jacintav/fotometro-portatil-icbm/electrónica/outputs/imagen 3D - pcb.png

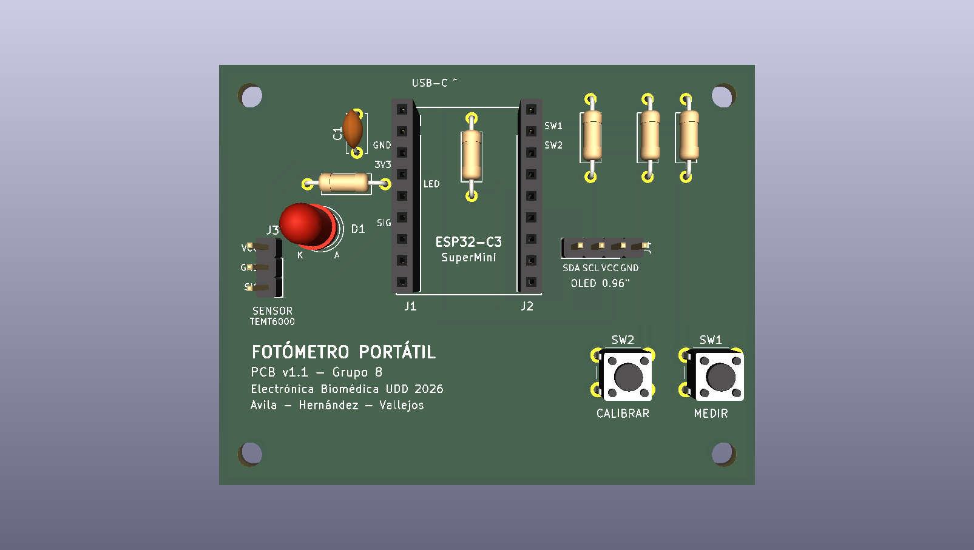
electrónica/outputs/imagen 3D - pcb.png
