jacintav/fotometro-portatil-icbm/software/README.md

# Software

Carpeta reservada para herramientas complementarias del proyecto. Por ahora no se utiliza, ya que el equipo funciona de forma autónoma con la pantalla OLED.
