jacintav/fotometro-portatil-icbm/electrónica/outputs/BOM.csv

Reference | Qty | Value | DNP | Exclude from BOM | Exclude from Board | Exclude from Simulation | Exclude from Position Files | Footprint | Datasheet
C1 | 1 | 100nF |  |  |  |  | ${EXCLUDE_FROM_POS_FILES} | Capacitor_THT:C_Disc_D5.0mm_W2.5mm_P5.00mm
D1 | 1 | LED |  |  |  |  | ${EXCLUDE_FROM_POS_FILES} | LED_THT:LED_D5.0mm
J1,J2 | 2 | Conn_01x09_Pin |  |  |  |  | ${EXCLUDE_FROM_POS_FILES} | Connector_PinSocket_2.54mm:PinSocket_1x09_P2.54mm_Vertical
J3 | 1 | Conn_01x03_Pin |  |  |  |  | ${EXCLUDE_FROM_POS_FILES} | Connector_PinHeader_2.54mm:PinHeader_1x03_P2.54mm_Vertical
J4 | 1 | Conn_01x04_Pin |  |  |  |  | ${EXCLUDE_FROM_POS_FILES} | Connector_PinHeader_2.54mm:PinHeader_1x04_P2.54mm_Vertical
R1 | 1 | 68Ω |  |  |  |  | ${EXCLUDE_FROM_POS_FILES} | Resistor_THT:R_Axial_DIN0207_L6.3mm_D2.5mm_P10.16mm_Horizontal
R2,R3 | 2 | 4.7kΩ |  |  |  |  | ${EXCLUDE_FROM_POS_FILES} | Resistor_THT:R_Axial_DIN0207_L6.3mm_D2.5mm_P10.16mm_Horizontal
R4,R5 | 2 | 10kΩ |  |  |  |  | ${EXCLUDE_FROM_POS_FILES} | Resistor_THT:R_Axial_DIN0207_L6.3mm_D2.5mm_P10.16mm_Horizontal
SW1,SW2 | 2 | SW_Push |  |  |  |  | ${EXCLUDE_FROM_POS_FILES} | Button_Switch_THT:SW_PUSH_6mm
