jacintav/fotometro-portatil-icbm/electrónica/outputs/archivo.step

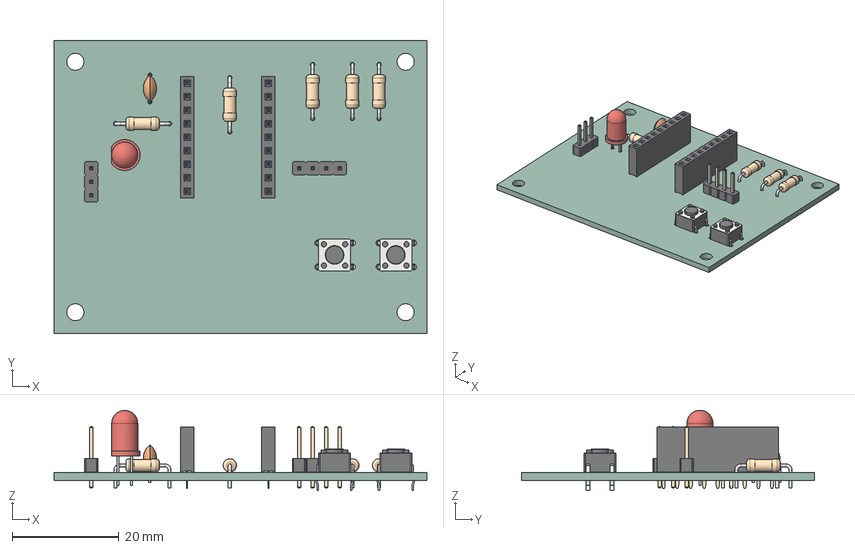
[picture p6: CAD file, 2026-11-03]
electrónica/outputs/archivo.step
70.0 x 55.0 x 15.1 mm
R_Axial_DIN0207_L63mm_D25mm_P1016mm_Horizontal x 5
LED_D5.0mm
PinSocket_1x09_P2.54mm_Vertical x 2
SW_PUSH_6mm x 2
PinHeader_1x03_P254mm_Vertical
C_Disc_D50mm_W25mm_P500mm
PinHeader_1x04_P254mm_Vertical
fotA137_PCB
