jacintav/fotometro-portatil-icbm/electrónica/outputs/esquematico pdf.pdf

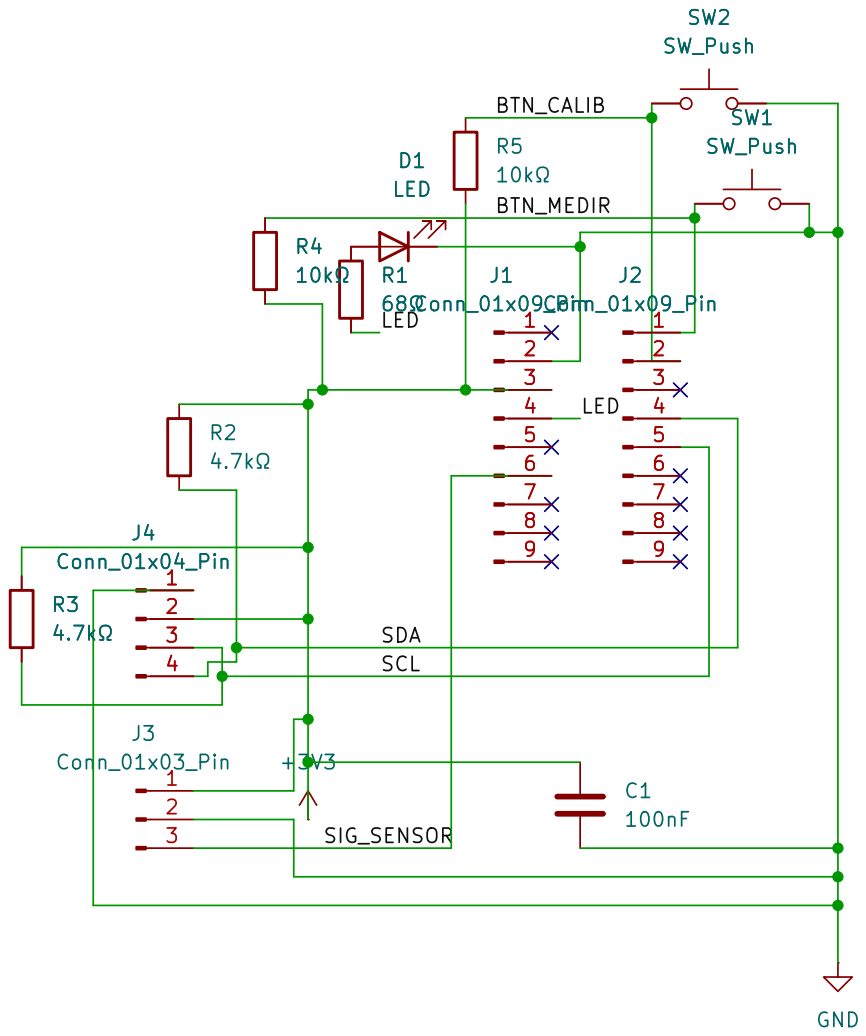
[picture p7: page 1]

Size: A4 | Rev:
KiCad E.D.A. 10.0.6 | Id: 1/1
