jacintav/fotometro-portatil-icbm/electrónica/Kicad/fotometro_portatil_pcb.kicad_pcb

## KiCad design electrónica/Kicad/fotometro_portatil_pcb.kicad_pcb (2026-11-02)

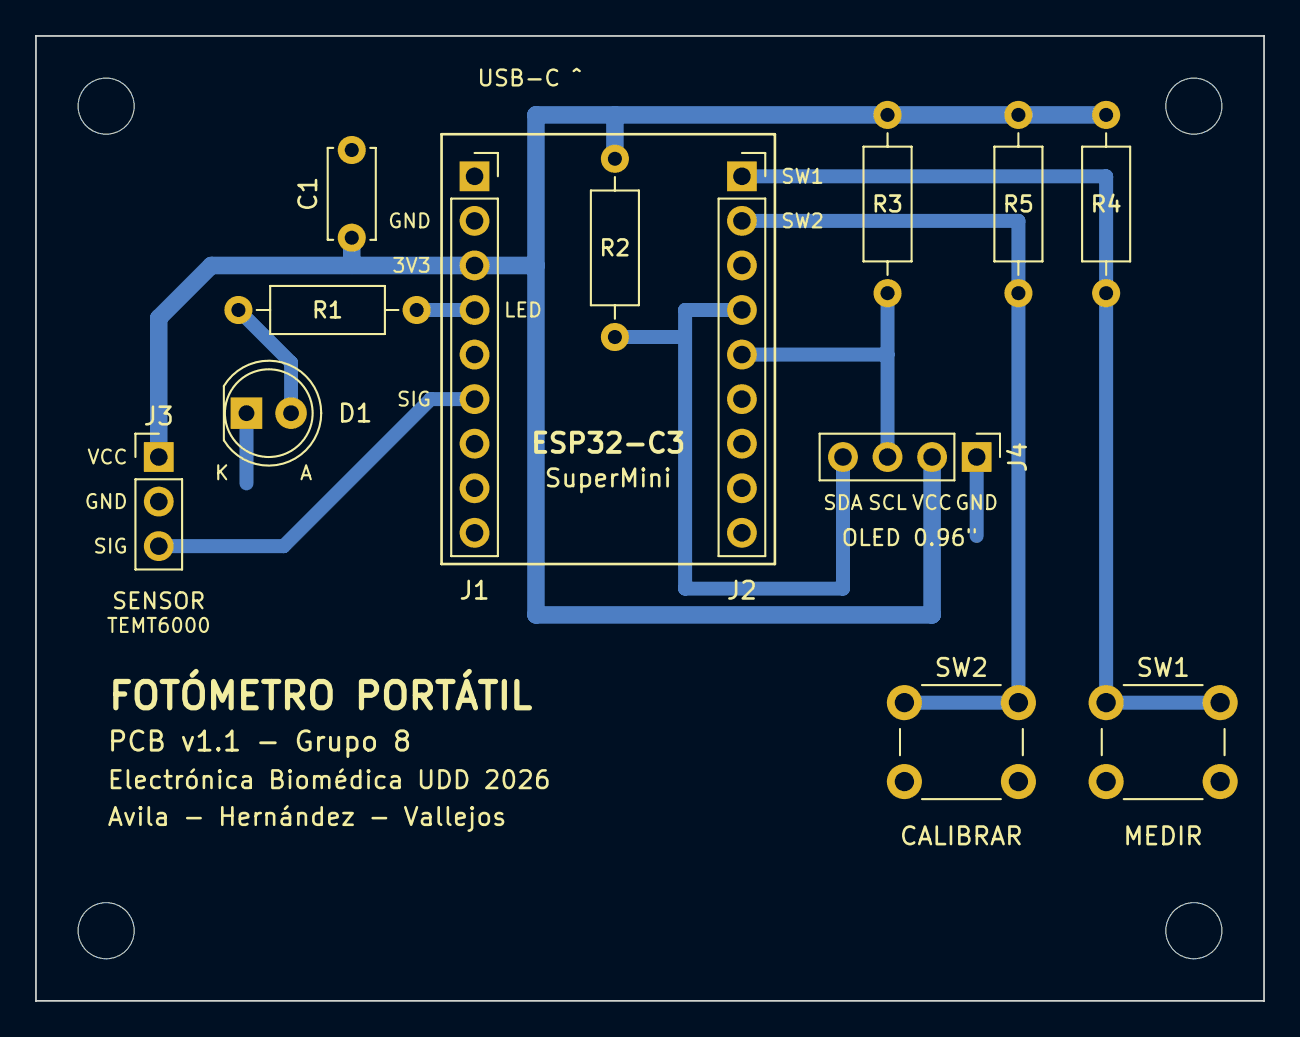
[picture p8: board fotometro_portatil_pcb.kicad_pcb from above]

Board: 2 copper layers, 70.0 x 55.0 mm, 17 parts (0 on the bottom side), 9 nets.

Parts:
C1: 100nF; C_Disc_D5.0mm_W2.5mm_P5.00mm
D1: LED verde; LED_D5.0mm
H1, H2, H3, H4: MountingHole_3.2mm_M3
J1: ESP32-C3 izq; PinSocket_1x09_P2.54mm_Vertical
J2: ESP32-C3 der; PinSocket_1x09_P2.54mm_Vertical
J3: TEMT6000; PinHeader_1x03_P2.54mm_Vertical
J4: OLED I2C; PinHeader_1x04_P2.54mm_Vertical
R1: 68Ω; R_Axial_DIN0207_L6.3mm_D2.5mm_P10.16mm_Horizontal
R2, R3: 4.7kΩ; R_Axial_DIN0207_L6.3mm_D2.5mm_P10.16mm_Horizontal
R4, R5: 10kΩ; R_Axial_DIN0207_L6.3mm_D2.5mm_P10.16mm_Horizontal
SW1: MEDIR; SW_PUSH_6mm
SW2: CALIBRAR; SW_PUSH_6mm

Connections:
+3V3: C1.1, J1.3, J3.1, J4.2, R2.1, R3.1, R4.2, R5.2
BTN_CALIB: J2.2, R5.1, SW2.1
BTN_MEDIR: J2.1, R4.1, SW1.1
GND: C1.2, D1.1, J1.2, J3.2, J4.1, SW1.2, SW2.2
LED: J1.4, R1.2
unnamed: D1.2, R1.1
SCL: J2.5, J4.3, R3.2
SDA: J2.4, J4.4, R2.2
SIG_SENSOR: J1.6, J3.3
