jacintav/fotometro-portatil-icbm/(commit log)

2026-11-05 actualización de esquematico y placa pcb
    [fotometro_portatil_pcb.kicad_sch, pcb.kicad_pcb]
2026-11-05 Agrega esquemático en PDF y BOM
    [BOM.csv]
2026-11-05 Agrega Gerber, drill y zip para fabricación
    [pcb-B_Cu.gbr, pcb-B_Mask.gbr, pcb-B_Paste.gbr, pcb-B_Silkscreen.gbr, pcb-Edge_Cuts.gbr, pcb-F_Cu.gbr, pcb-F_Mask.gbr, pcb-F_Paste.gbr]
2026-11-05 Agrega STEP e imágenes de la PCB
    [archivo.step]
2026-11-05 Renombrar archivo de la placa
    [fotometro_portatil_pcb.kicad_pcb]
2026-11-05 Add initial README for ESP32-C3 SuperMini firmware
